MrRox1337/range-balancing-bot/media/ideation-draft.jpg

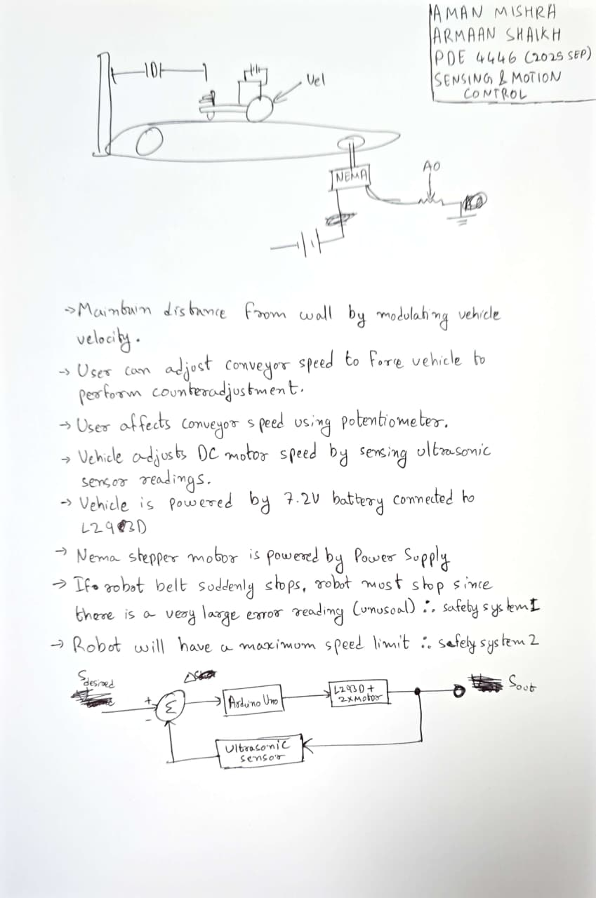
media/ideation-draft.jpg
