MrRox1337/range-balancing-bot/(commit log)

2025-10-21 Added Prototype 1.jpg
    Contains the information on details of the project. The modules used, safety systems, and closed loop system diagram.
2025-10-27 Added range-balancing-bot-test.ino Added range-balancing-bot.ino
    Features: PID with accepted tolerance achieved
    [range-balancing-bot-test.ino, range-balancing-bot.ino]
2025-10-27 Updated range-balancing-bot.ino Removed setpointVariance error
    [range-balancing-bot.ino]
2025-10-28 Added variable-conveyor-belt.ino
    Controllable conveyor belt speed with potentiometer and in-line vdd switch.
2025-10-29 Refine PID parameters and improve motor control logic for range-balancing bot
2025-10-29 Refactor PID parameters for conveyor belt
2025-10-29 Adjust output limits for PID control in range-balancing bot Reduced response rate Increased PWM floor
2025-10-29 Refactor PID parameters and motor control logic for best performance on floor
2025-10-31 Circuit Connection for NEMA17 Stepper motor.
2025-11-01 Added car wiring sketch in media
2025-11-01 Added wire diagrams
2025-11-01 Enhance README.md with detailed conveyor integration and PID implementation steps
2025-11-01 Added conveyor belt and robot pictures
2025-11-02 Refine README.md for clarity and detail. Add Results with demonstration video Add Images for robot and conveyor belt sketches, hardware, and wiring Add References
